haxwithaxe/spiffchorder/tags/release/0.99/readme.txt

SpiffChorder - Spaceman Spiff's Chording Keyboard Experiment
Copyright (C) 2006-2012  Mikkel Holm Olsen

This program is free software: you can redistribute it and/or modify
it under the terms of the GNU General Public License as published by
the Free Software Foundation, either version 3 of the License, or
(at your option) any later version.

This program is distributed in the hope that it will be useful,
but WITHOUT ANY WARRANTY; without even the implied warranty of
MERCHANTABILITY or FITNESS FOR A PARTICULAR PURPOSE.  See the
GNU General Public License for more details.

You should have received a copy of the GNU General Public License
along with this program.  If not, see <http://www.gnu.org/licenses/>.

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

For the latest information regarding the SpiffChorder, check the 
project homepage:

  http://symlink.dk/projects/spiffchorder/

and the wiki:

  http://chorder.cs.vassar.edu/spiffchorder/forside

Both the hardware design and software/firmware for the SpiffChorder
is open, and you can make modifications as you see fit. Both the hardware
design and the source code for the software/firmware and driver are
released under the terms of the GNU GPL v3.

Objective Development's V-USB driver (Previously AVR-USB) is a firmware-only 
implementation of the low speed USB standard (1.5Mbps) which can be used on 
cheap AVR microcontrollers from Atmel.

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

Legacy hardware
---------------

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

Building the hardware
---------------------

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

Building the firmware
---------------------

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

Before attempting to compile, edit the Makefile to select the
desired chord mapping and programmer options.

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

Boot loader
-----------

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

Troubleshooting
---------------

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

Files
-----
readme.txt              This file.
changes.txt             What has been changed in the different versions.
doc.txt                 Extra documentation (for further development).
license.txt             The license this project is released under.
circuit/                Directory with circuit diagrams in PDF and PNG formats.
usbdrv/                 Directory with the V-USB driver.
keymaps/                Keyboard maps (chord maps).
Makefile                Build instructions for GNU Make.
main.c                  Main source code file.
main.hex                Compiled version, ready to be programmed into uC.
usbconfig.h             Configuration for V-USB stack.

License information
-------------------

The SpiffChorder project is based on Objective Development's HIDkeys demo 
application, which is released under the terms of the GNU GPL v2 or v3.

The SpiffChorder project is released under the terms of the GNU GLP v3.

Further more we strongly encurage any derivative work to disclose circuit
documentation.

See the file license.txt for details.

Copyright
---------

The SpiffChorder project and documentation is Copyright (C) 2006-2012
by Mikkel Holm Olsen (AKA Spaceman Spiff). More information about the
project can be found on http://symlink.dk/projects/spiffchorder/.

$Id$
