haxwithaxe/spiffchorder/tags/release/0.99/circuit/chorder.png

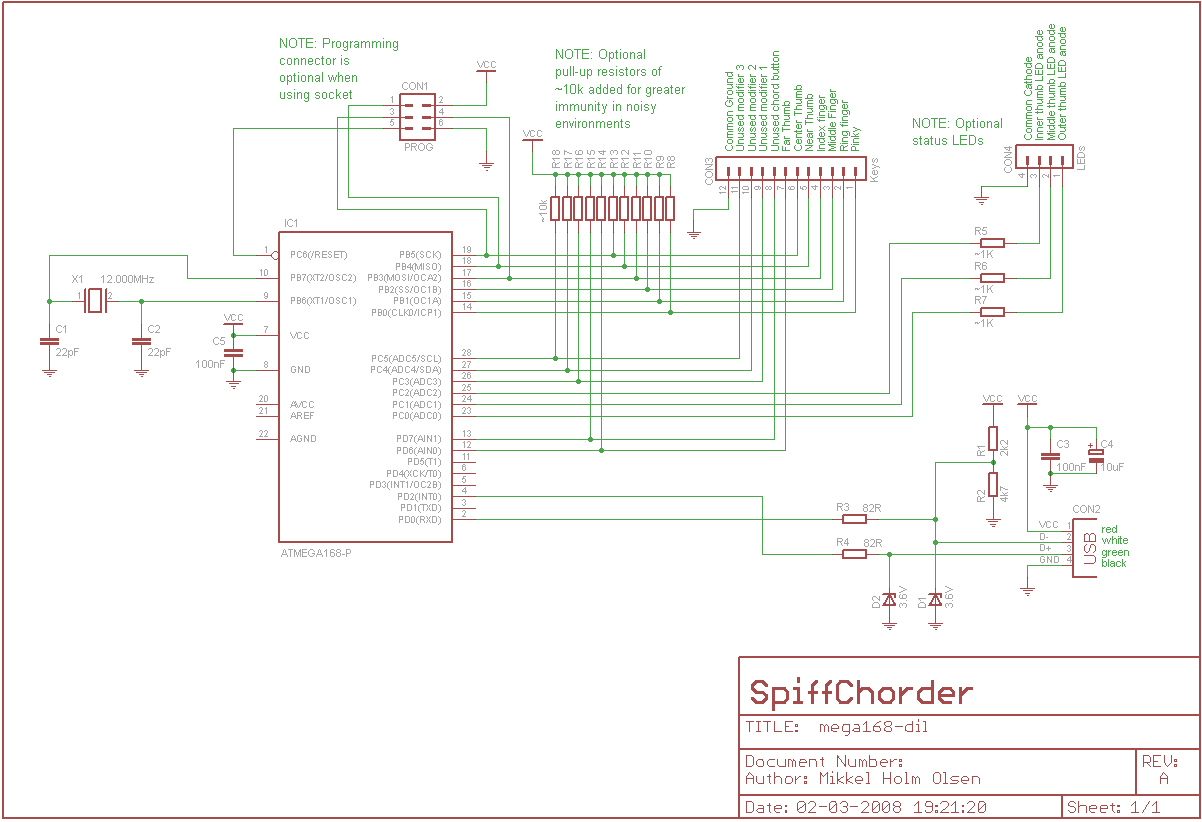
tags/release/0.99/circuit/chorder.png
