haxwithaxe/spiffchorder/tags/release/0.99/circuit/chorder.pdf

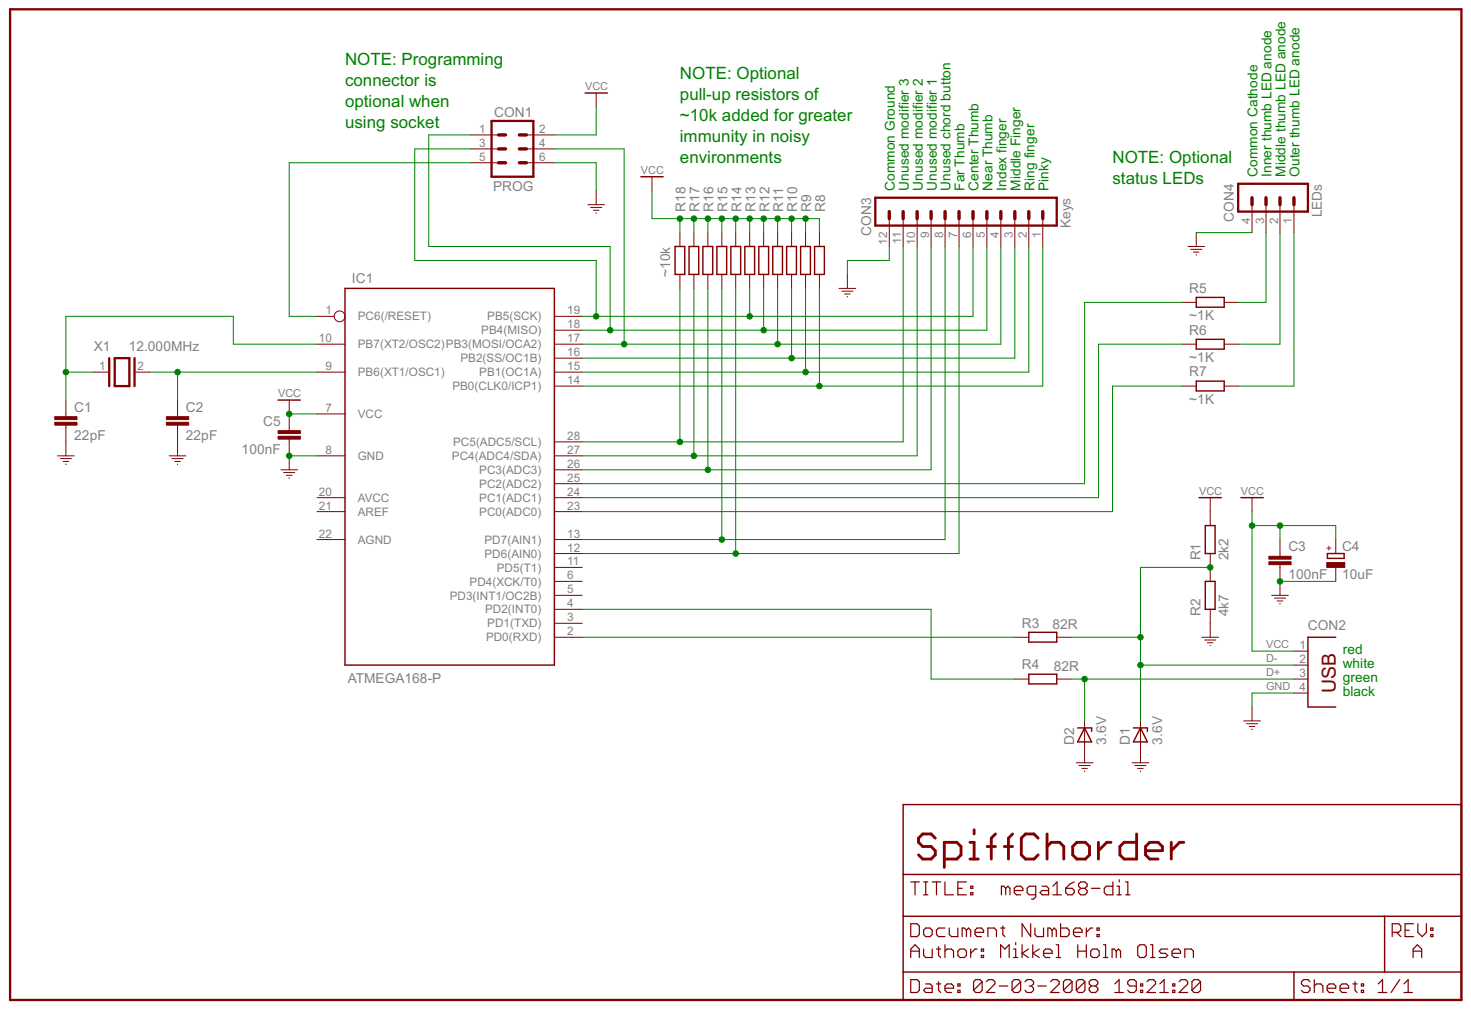
[picture p2: page 1]

Inner thumb LED anode Middle thumb LED anode Outer thumb LED anode Com

NOTE: Optional
pull-up resistors of ~10k added for greater

status LEDs Unused modifier 3 Unused modifier 2 Unused modifier 1 Unused chord button

Index finger Near Thumb Center Thumb Far Thumb Com
