haxwithaxe/spiffchorder/tags/release/0.98/circuit/chorder.pdf

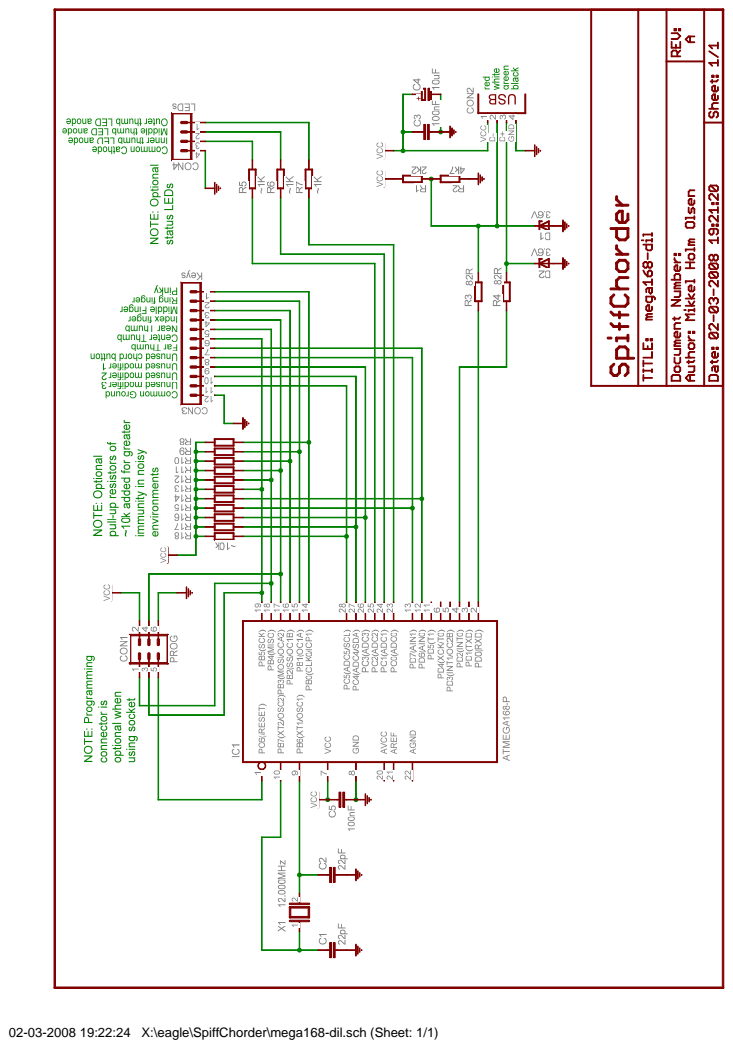
[picture p3: page 1]

02-03-2008 19:22:24 X:\eagle\SpiffChorder\mega168-dil.sch (Sheet: 1/1)
