haxwithaxe/spiffchorder/tags/release/0.99/USBaspLoader.2008-02-05/Changelog.txt

This file documents changes in the firmware of USBaspLoader.
New entries are always appended to the end of the file. Scroll down to the
bottom to see the most recent changes.

* Release 2008-01-21

- Use most recent driver.

* Release 2008-02-05
