haxwithaxe/spiffchorder/(commit log)

2008-02-24 Initial USB driver
2008-02-24 Bugfix: Macros work again (but are still 8-bit).
    [main.c]
2008-03-04 Changed VID/PID. Updated documentation.
2008-03-07 Updated driver.
2008-03-07 Legacy hardware, fuse settings.
2008-03-07 Fuse settings for ATmega168.
2008-03-08 Fixed mode after repeat-bug. Fixed macros don't clear state bug. Minor cleanup. Released as 0.98.
    [main.c]
2012-01-22 Schematics generated again (no changes). Minor BOM clarifications.
